TNCTRobocon/DROID/Reference/MDUdisaster_v4.1/MDU(droid)v4.1.brd

## EAGLE design Reference/MDUdisaster_v4.1/MDU(droid)v4.1.brd (2018-09-09)

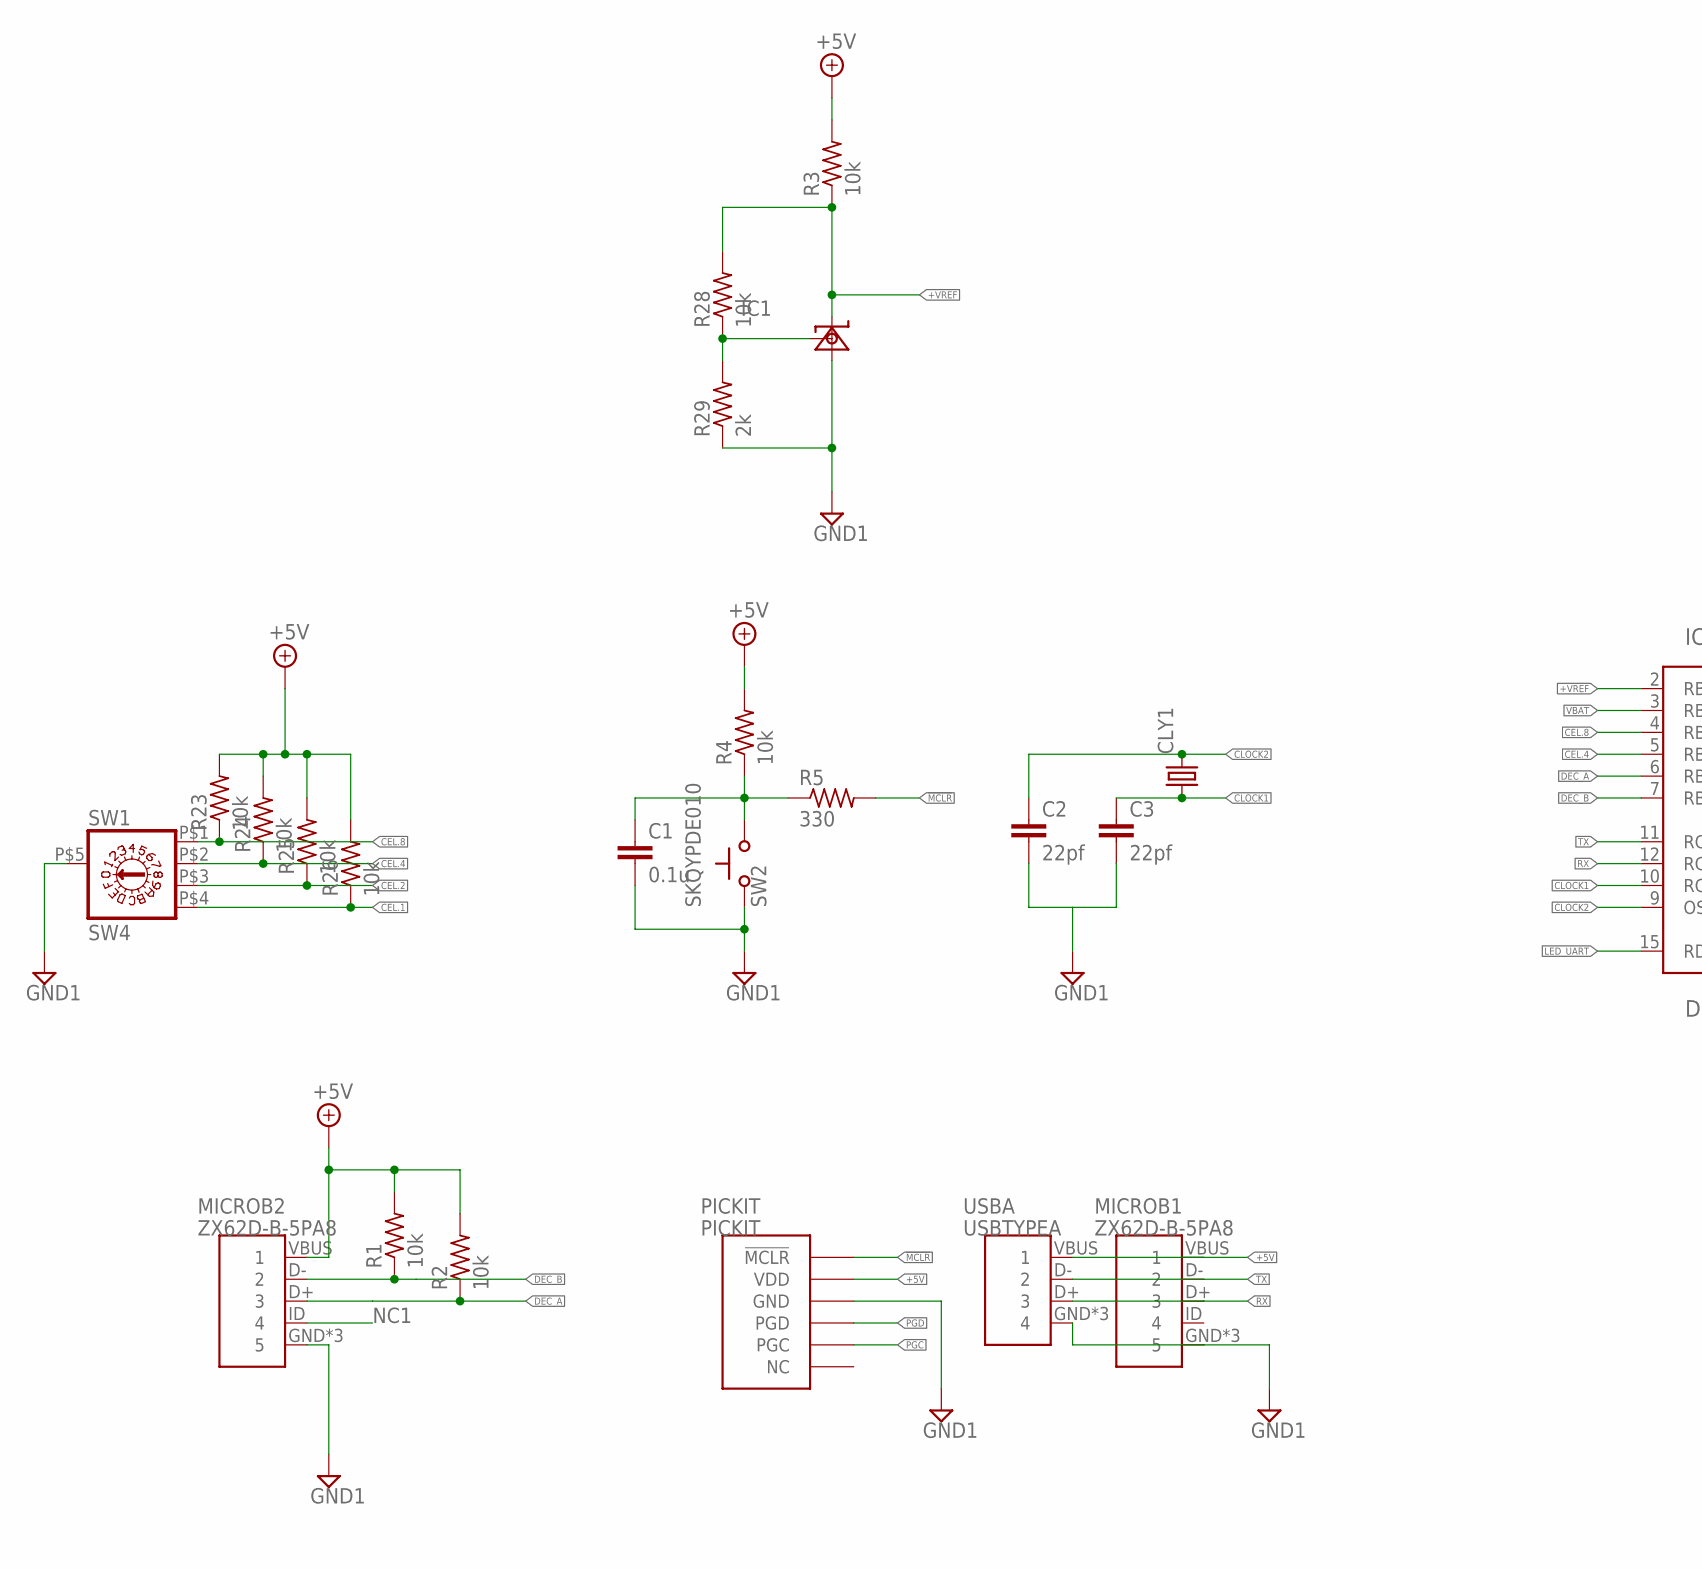
[picture p1: schematic MDU(droid)v4.1.sch, sheet 1, IC部, part in row 1, column 1]

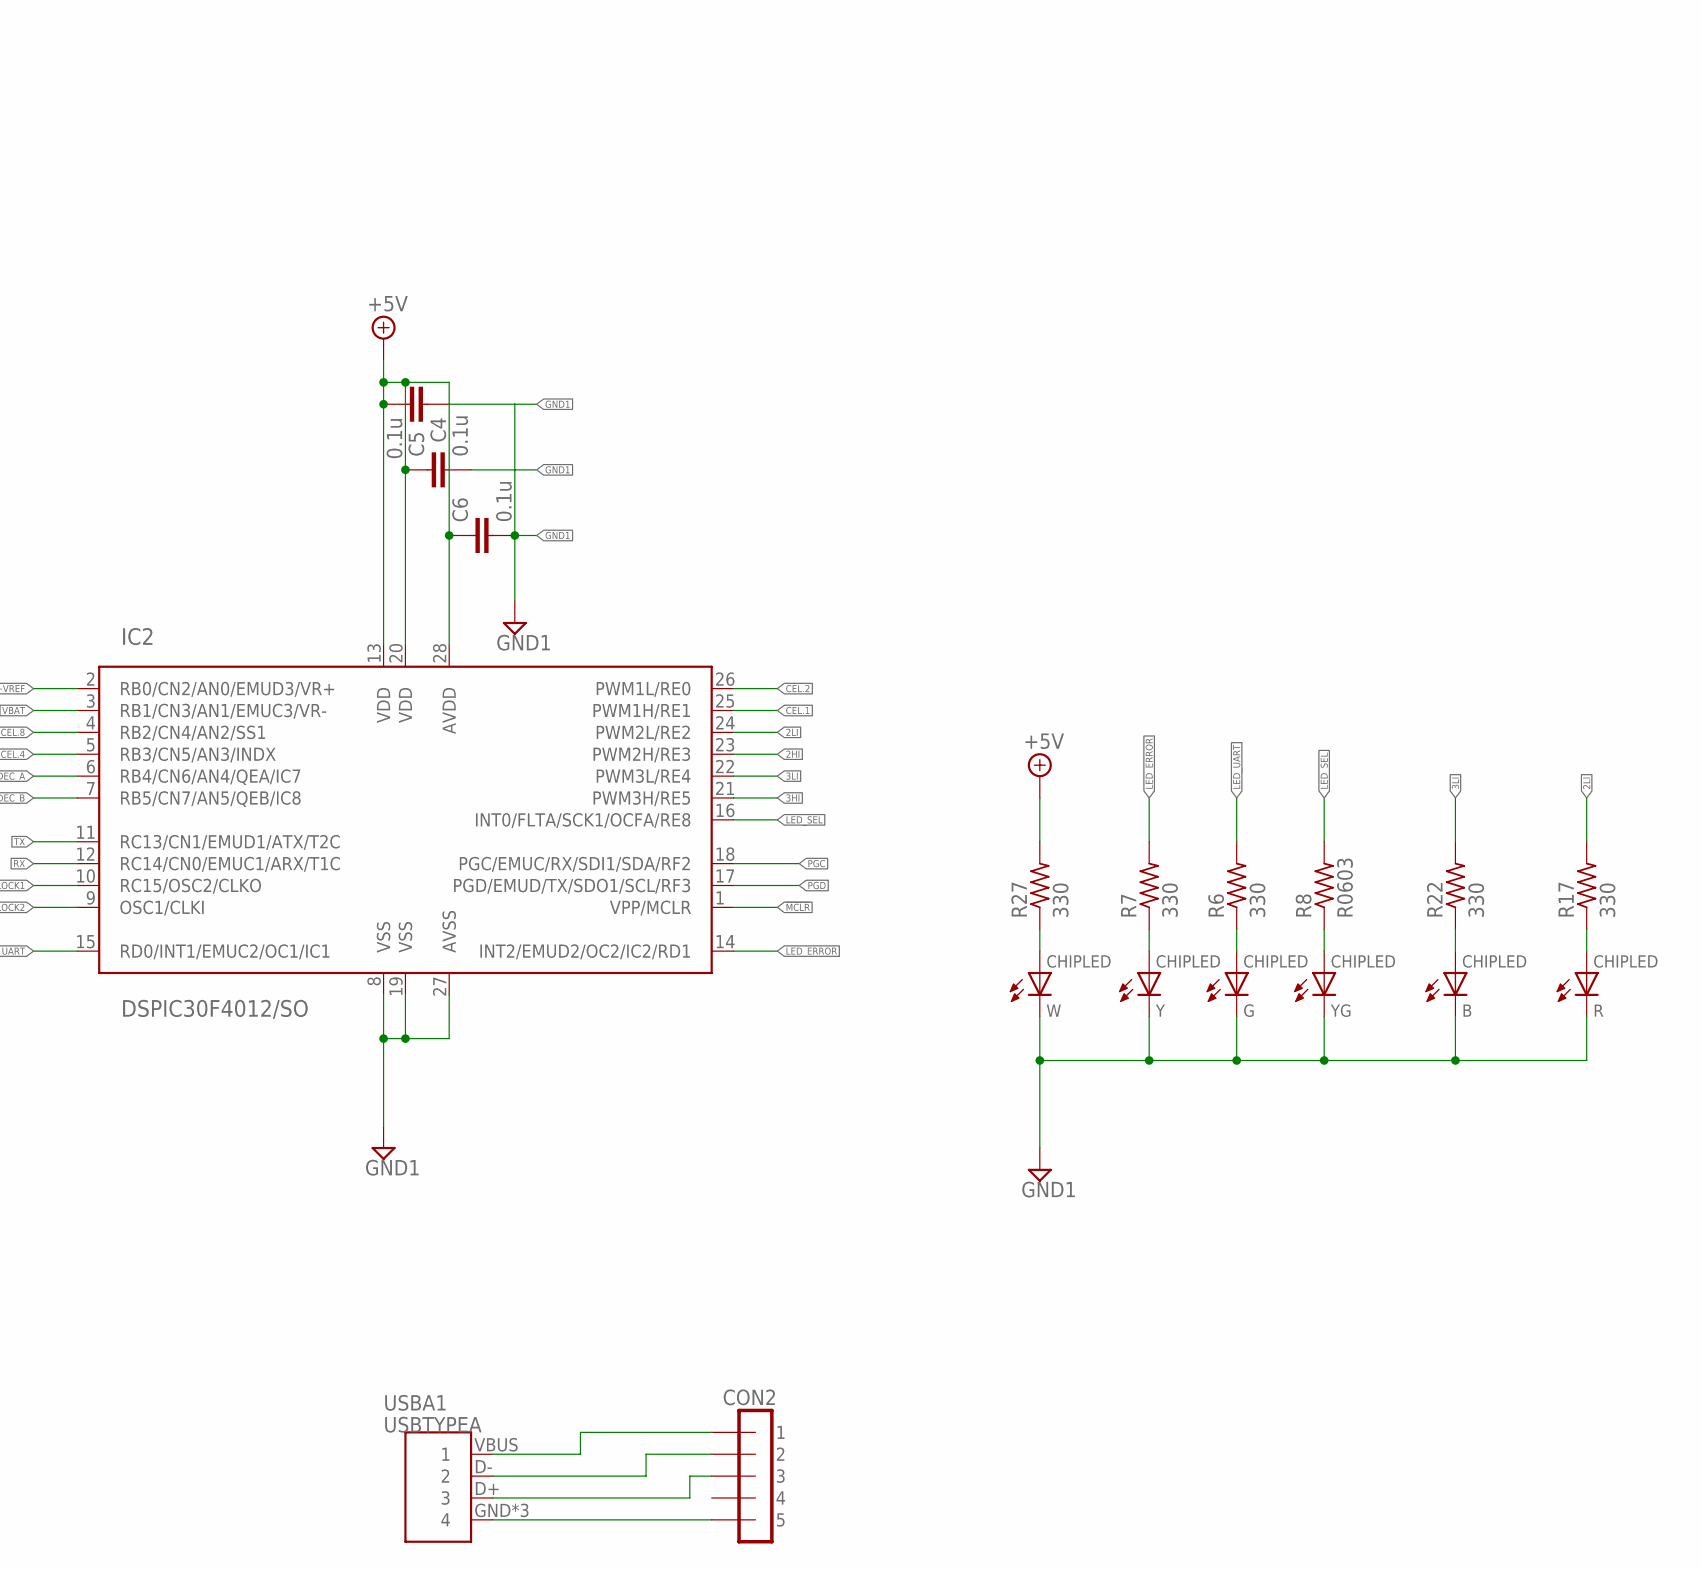
[picture p2: schematic MDU(droid)v4.1.sch, sheet 1, IC部, part in row 1, column 2]

Parts:
B: CHIPLED; CHIPLED_0603
C1, C4, C5, C6: 0.1u; C0603
C2, C3: 22pf; C0603
CLY1: CRYSTALHC49S; HC49/S
CON2: CON-5; 5-L
G: CHIPLED; CHIPLED_0603
IC1: TA76431F; SOT89
IC2: DSPIC30F4012/SO; SO-28W
MICROB1, MICROB2: ZX62D-B-5PA8; USB-B-MICRO-SMD
PICKIT: PICKIT; 1X06
R: CHIPLED; CHIPLED_0603
R1, R2, R3, R4, R23, R24, R25, R26, R28: 10k; R0603
R5, R6, R7, R17, R22, R27: 330; R0603
R8: R0603
R29: 2k; R0603
SW1: SW4; DRS3016
SW2: SKQYPDE010
USBA, USBA1: USBTYPEA; USB-A-H
W: CHIPLED; CHIPLED_0603
Y: CHIPLED; CHIPLED_0603
YG: CHIPLED; CHIPLED_0603

Connections:
2HI: IC2.23 (PWM2H/RE3); also elsewhere on the board
2LI: IC2.24 (PWM2L/RE2), R17.2; also elsewhere on the board
3HI: IC2.21 (PWM3H/RE5); also elsewhere on the board
3LI: IC2.22 (PWM3L/RE4), R22.2; also elsewhere on the board
!MCLR: IC2.1 (VPP/MCLR), PICKIT.1 (!MCLR), R5.2
+5V: C4.2, C5.1, C6.1, IC2.13 (VDD), IC2.20 (VDD), IC2.28 (AVDD), MICROB1.VBUS (1), MICROB2.VBUS (1), PICKIT.2 (VDD), R1.2, R2.2, R3.2, R4.2, R23.2, R24.2, R25.2, R26.2, R27.2, USBA.VBUS (1)
+VREF: IC1.1 (K), IC2.2 (RB0/CN2/AN0/EMUD3/VR+), R3.1, R28.2
CEL.1: IC2.25 (PWM1H/RE1), R26.1, SW1.P$4 (8)
CEL.2: IC2.26 (PWM1L/RE0), R25.1, SW1.P$3 (4)
CEL.4: IC2.5 (RB3/CN5/AN3/INDX), R24.1, SW1.P$2 (2)
CEL.8: IC2.4 (RB2/CN4/AN2/SS1), R23.1, SW1.P$1 (1)
CLOCK1: C3.1, CLY1.1, IC2.10 (RC15/OSC2/CLKO)
CLOCK2: C2.1, CLY1.2, IC2.9 (OSC1/CLKI)
DEC_A: IC2.6 (RB4/CN6/AN4/QEA/IC7), MICROB2.D+ (3), R2.1
DEC_B: IC2.7 (RB5/CN7/AN5/QEB/IC8), MICROB2.D- (2), R1.1
GND1: B.C, C1.2, C2.2, C3.2, C4.1, C5.2, C6.2, G.C, IC1.2 (A), IC1.2@1 (A), IC2.8 (VSS), IC2.19 (VSS), IC2.27 (AVSS), MICROB1.GND (5), MICROB1.SHIELD1 (5), MICROB1.SHIELD2 (5), MICROB2.GND (5), MICROB2.SHIELD1 (5), MICROB2.SHIELD2 (5), PICKIT.3 (GND), R.C, R29.1, SW1.P$5 (C), SW2.SW1, USBA.GND (4), USBA.SHLD1 (4), USBA.SHLD2 (4), W.C, Y.C, YG.C; also elsewhere on the board
LED_ERROR: IC2.14 (INT2/EMUD2/OC2/IC2/RD1), R7.2
LED_SEL: IC2.16 (INT0/FLTA/SCK1/OCFA/RE8), R8.2
LED_UART: IC2.15 (RD0/INT1/EMUC2/OC1/IC1), R6.2
MCLR: C1.1, R4.1, R5.1, SW2.SW2
unnamed: R27.1, W.A
unnamed: G.A, R6.1
unnamed: R8.1, YG.A
unnamed: IC1.3 (REF), R28.1, R29.2
unnamed: CON2.P$1 (1), USBA1.VBUS (1)
unnamed: CON2.P$5 (5), USBA1.GND (4), USBA1.SHLD1 (4), USBA1.SHLD2 (4)
unnamed: CON2.P$2 (2), USBA1.D- (2)
unnamed: R7.1, Y.A
unnamed: R.A, R17.1
unnamed: B.A, R22.1
unnamed: CON2.P$3 (3), USBA1.D+ (3)
NC1: MICROB2.ID (4)
PGC: IC2.18 (PGC/EMUC/RX/SDI1/SDA/RF2), PICKIT.5 (PGC)
PGD: IC2.17 (PGD/EMUD/TX/SDO1/SCL/RF3), PICKIT.4 (PGD)
RX: IC2.12 (RC14/CN0/EMUC1/ARX/T1C), MICROB1.D+ (3), USBA.D+ (3)
TX: IC2.11 (RC13/CN1/EMUD1/ATX/T2C), MICROB1.D- (2), USBA.D- (2)
VBAT: IC2.3 (RB1/CN3/AN1/EMUC3/VR-); also elsewhere on the board

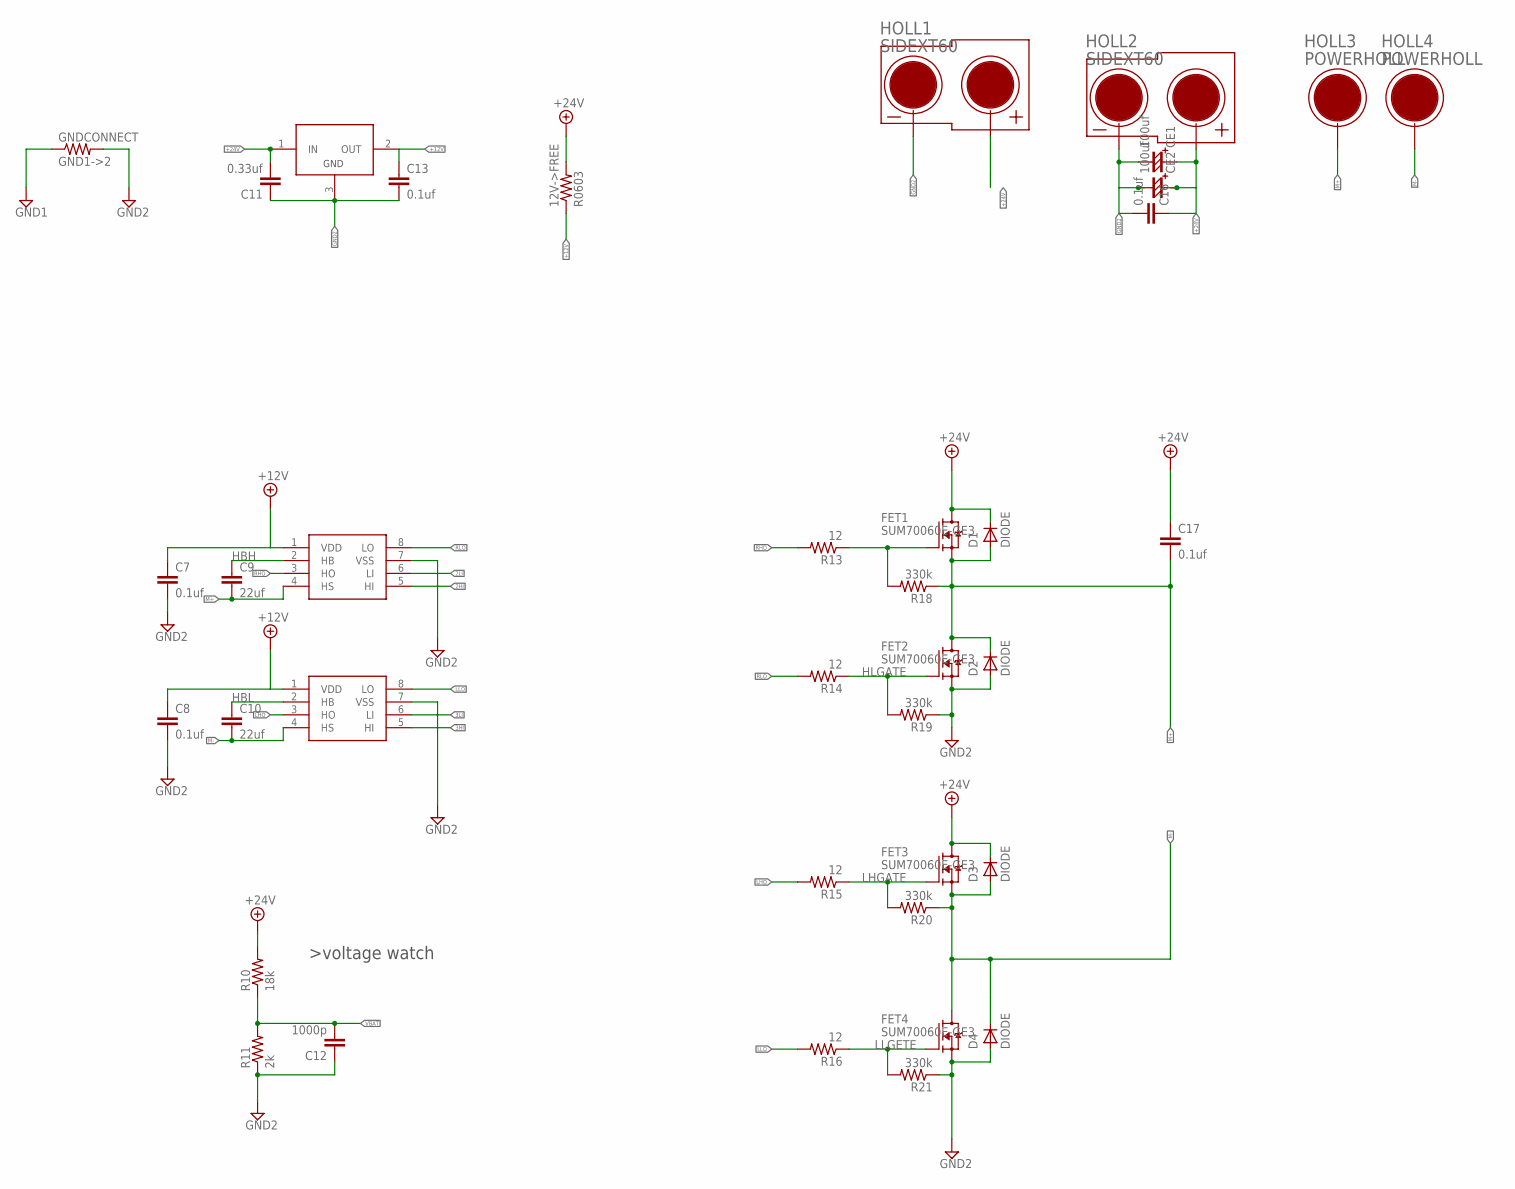
[picture p3: schematic MDU(droid)v4.1.sch, sheet 2, 駆動部]

Parts:
12V->FREE: R0603
C7, C8, C13, C16, C17: 0.1uf; C0603
C9, C10: 22uf; C0603
C11: 0.33uf; C0603
C12: 1000p; C0603
CE1, CE2: 100uf; CE1
D1, D2, D3, D4: DIODE; DO35-7A
FET1, FET2, FET3, FET4: SUM70060E-GE3; TO263AB
GNDCONNECT: GND1->2; R0603
HOLL1, HOLL2: SIDEXT60
HOLL3, HOLL4: POWERHOLL
IC3: MC7812BD2TG; TO263
IC5: MIC4604; SOIC8
MIC4604: MIC4604; SOIC8
R10: 18k; R0603
R11: 2k; R0603
R13, R14, R15, R16: 12; R0603
R18, R19, R20, R21: 330k; R0603

Connections:
2HI: MIC4604.5 (HI); also elsewhere on the board
2LI: MIC4604.6 (LI); also elsewhere on the board
3HI: IC5.5 (HI); also elsewhere on the board
3LI: IC5.6 (LI); also elsewhere on the board
+12V: 12V->FREE.1, C7.1, C8.1, C13.1, IC3.2 (OUT), IC5.1 (VDD), MIC4604.1 (VDD)
+24V: 12V->FREE.2, C11.2, C16.1, C17.1, CE1.1 (A), CE2.1 (A), D1.C, D3.C, FET1.K (D), FET3.K (D), HOLL1.P$2, HOLL1.P$4, HOLL2.P$2, HOLL2.P$4, IC3.1 (IN), R10.2
FETHHGATE: FET1.1 (G), R13.1, R18.2
GND1: GNDCONNECT.1; also elsewhere on the board
GND2: C7.2, C8.2, C11.1, C12.1, C13.2, C16.2, CE1.2 (C), CE2.2 (C), D2.A, D4.A, FET2.2 (S), FET4.2 (S), GNDCONNECT.2, HOLL1.P$1, HOLL1.P$3, HOLL2.P$1, HOLL2.P$3, IC3.3 (GND), IC5.7 (VSS), MIC4604.7 (VSS), R11.1, R19.1, R21.1
HBH: C9.1, MIC4604.2 (HB)
HBL: C10.1, IC5.2 (HB)
HLGATE: FET2.1 (G), R14.1, R19.2
LHGATE: FET3.1 (G), R15.1, R20.2
LHO: IC5.3 (HO), R15.2
LLGETE: FET4.1 (G), R16.1, R21.2
LLO: IC5.8 (LO), R16.2
M+: C9.2, C17.2, D1.A, D2.C, FET1.2 (S), FET2.K (D), HOLL3.P$1, MIC4604.4 (HS), R18.1
M-: C10.2, D3.A, D4.C, FET3.2 (S), FET4.K (D), HOLL4.P$1, IC5.4 (HS), R20.1
RHO: MIC4604.3 (HO), R13.2
RLO: MIC4604.8 (LO), R14.2
VBAT: C12.2, R10.1, R11.2; also elsewhere on the board

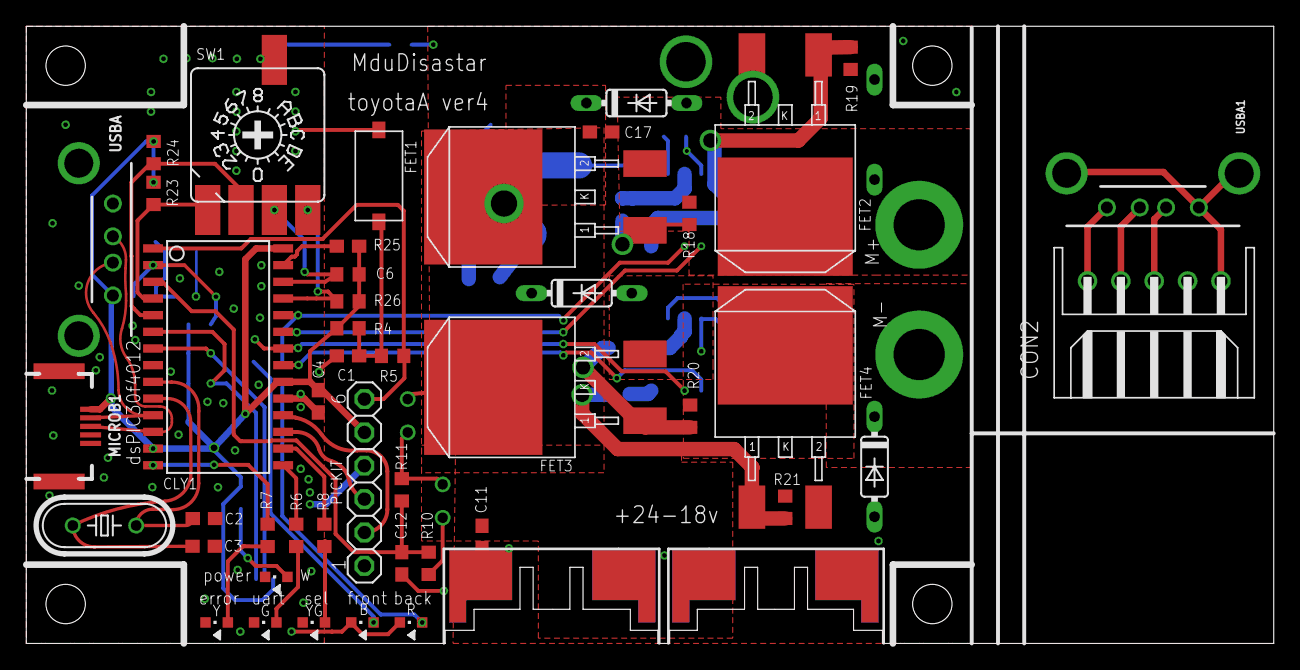
[picture p4: board MDU(droid)v4.1.brd from above]

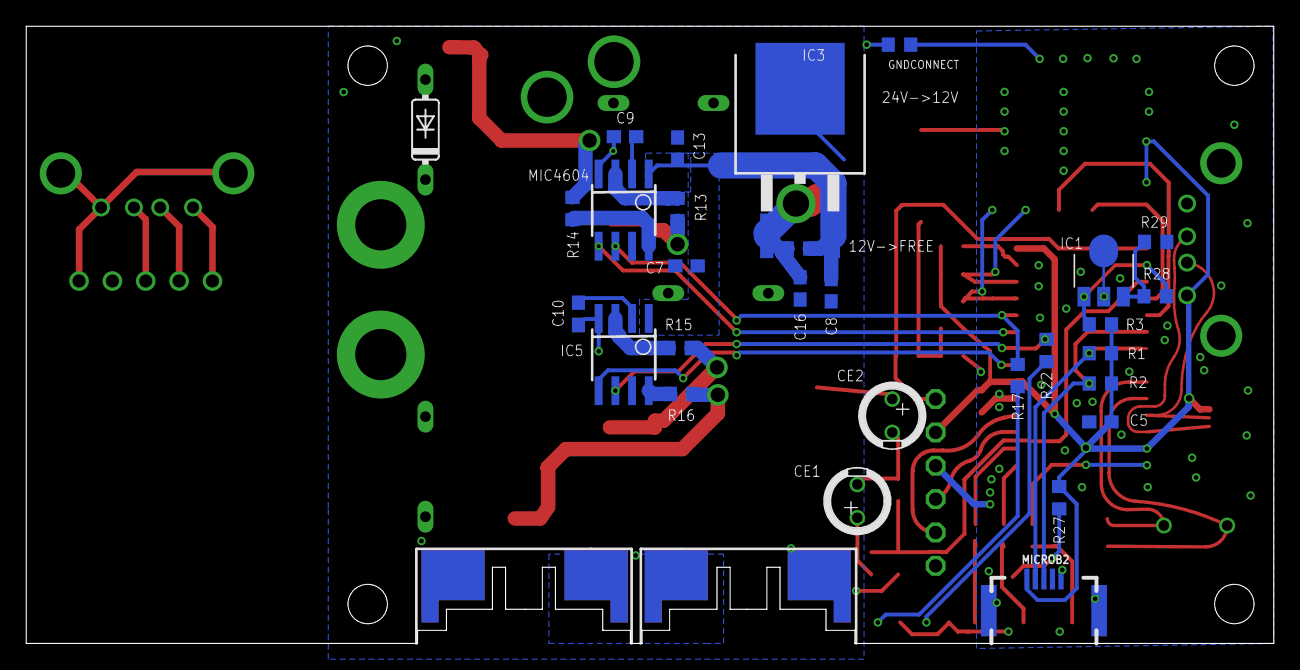
[picture p5: board MDU(droid)v4.1.brd from below]

Board: 2 copper layers, 95.0 x 47.0 mm, 78 parts (30 on the bottom side), 51 nets.
