TNCTRobocon/DROID/Setting/configuration.h

/* 
 * File:   configuration.h
 * Author: TERU
 *
 * Created on 2016/03/23, 0:16
 */

#ifndef CONFIGURATION_H
#define	CONFIGURATION_H


//デバイス環境
#include "p30F4012.h"


//環境構築
#define FORIG (1000000UL)
#define FOSC (FORIG*8/4) //10[MHz]*8[PLL]/4[DIV]=20[MHz] 

//10MHz*8(PLL)/4(divsion))

//デバイスを選択する
#define DEVICE_COMMON
//#define DEVICE_DRAGON
#define ADC_USE
#if defined(DEVICE_COMMON)
#define PORT_TYPE_A
#elif defined(DEVICE_DRAGON)
#define PORT_TYPE_B

#endif


//アドレス取得　ピン配置
#if defined(PORT_TYPE_A)
#define PIN_SEL1() PORTBbits.RB2
#define PIN_SEL2() PORTEbits.RE8
#define PIN_SEL4() PORTEbits.RE0
#define PIN_SEL8() PORTEbits.RE1
#define TRIS_SEL1(X) TRISBbits.TRISB2=(X)
#define TRIS_SEL2(X) TRISEbits.TRISE8=(X)
#define TRIS_SEL4(X) TRISEbits.TRISE0=(X)
#define TRIS_SEL8(X) TRISEbits.TRISE1=(X)
#elif defined(PORT_TYPE_B)

//TODO ピン配置を設定する
#endif
//Stoper
#define SW_ST()   PORTEbits.RE8

//LED
#define LED_RX      LATDbits.LATD0
#define LED_TX      LATDbits.LATD1
#define LED_ERROR   LATDbits.LATD1
#define LED_APP     LATBbits.LATB2

#define PIN_HIGH(x) ((x)=true)
#define PIN_LOW(x)  ((x)=false)
#define PIN_INV(x)  ((x)=(^x))

//PWM
#define ST_PIN      LATEbits.LATE4
//UART
#define RX_BUFFER_SIZE  (64) //受信バッファの一つ当たりの大きさ
#define TX_BUFFER_SIZE  (64)
#define CMD_LENGTH (32)        // システムが受け入れられる文字の最大数、
#define CMD_MAX     (16)        // 最大分割数(1LINEあたり)
#define FILE_MAX    (32)        // 最大ファイル数
#define MULTI_MAX (8) //同時に実行できるコマンドの最大値
#define WORD_MAX (32)
#define PATH_DEPTH_MAX (8)
#define QUICK_MAX (8) 
#define WORD_MAX (32)
#define SYSTEM_SIZE (32)        //  システムに登録できる機能数

//EEPROM
#define EEPROM_BUFFER_SIZE (64) //EEPROMの書き込み用バッファ

//ADC





#endif	/* CONFIGURATION_H */
