TNCTRobocon/DROID/Setting/configuration.c

// DSPIC30F4012 Configuration Bit Settings

// 'C' source line config statements

#include "configuration.h"


// DSPIC30F4012 Configuration Bit Settings

// 'C' source line config statements



// FOSC
#pragma config FPR = XT_PLL8           // Primary Oscillator Mode (XT w/PLL 8x)
#pragma config FOS = PRI                // Oscillator Source (Primary Oscillator)
#pragma config FCKSMEN = CSW_FSCM_OFF   // Clock Switching and Monitor (Sw Disabled, Mon Disabled)

// FWDT
#pragma config FWPSB = WDTPSB_16        // WDT Prescaler B (1:16)
#pragma config FWPSA = WDTPSA_512       // WDT Prescaler A (1:512)
#pragma config WDT = WDT_OFF            // Watchdog Timer (Disabled)

// FBORPOR
#pragma config FPWRT = PWRT_64          // POR Timer Value (64ms)
#pragma config BODENV = BORV42          // Brown Out Voltage (4.2V)
#pragma config BOREN = PBOR_ON          // PBOR Enable (Enabled)
#pragma config LPOL = PWMxL_ACT_LO      // Low-side PWM Output Polarity (Active High)
#pragma config HPOL = PWMxH_ACT_HI      // High-side PWM Output Polarity (Active High)
#pragma config PWMPIN = RST_IOPIN       // PWM Output Pin Reset (Control with PORT/TRIS regs)
#pragma config MCLRE = MCLR_EN          // Master Clear Enable (Enabled)

// FGS
#pragma config GWRP = GWRP_OFF          // General Code Segment Write Protect (Disabled)
#pragma config GCP = CODE_PROT_OFF      // General Segment Code Protection (Disabled)

// FICD
#pragma config ICS = ICS_PGD            // Comm Channel Select (Use PGC/EMUC and PGD/EMUD)

/*
// FOSC
#pragma config FPR = FRC_PLL8           // Primary Oscillator Mode (FRC w/ PLL 8x)
#pragma config FOS = FRC                // Oscillator Source (Internal Fast RC)
#pragma config FCKSMEN = CSW_FSCM_OFF   // Clock Switching and Monitor (Sw Disabled, Mon Disabled)

// FWDT
#pragma config FWPSB = WDTPSB_16        // WDT Prescaler B (1:16)
#pragma config FWPSA = WDTPSA_512       // WDT Prescaler A (1:512)
#pragma config WDT = WDT_OFF            // Watchdog Timer (Disabled)

// FBORPOR
#pragma config FPWRT = PWRT_64          // POR Timer Value (64ms)
#pragma config BODENV = BORV42          // Brown Out Voltage (4.2V)
#pragma config BOREN = PBOR_ON          // PBOR Enable (Enabled)
#pragma config LPOL = PWMxL_ACT_HI      // Low-side PWM Output Polarity (Active High)
#pragma config HPOL = PWMxH_ACT_HI      // High-side PWM Output Polarity (Active High)
#pragma config PWMPIN = RST_IOPIN       // PWM Output Pin Reset (Control with PORT/TRIS regs)
#pragma config MCLRE = MCLR_EN          // Master Clear Enable (Enabled)

// FGS
#pragma config GWRP = GWRP_OFF          // General Code Segment Write Protect (Disabled)
#pragma config GCP = CODE_PROT_OFF      // General Segment Code Protection (Disabled)

// FICD
#pragma config ICS = ICS_PGD            // Comm Channel Select (Use PGC/EMUC and PGD/EMUD)
*/
