TNCTRobocon/DROID/Driver/ports.c

#include "../Setting/configuration.h"
#include "ports.h"

void ports_setup(){
    //Switch (STOP)
    //TRISEbits.TRISE8=true;
    //Switch Address (Din)
    TRIS_SEL1(true);
    TRIS_SEL2(true);
    TRIS_SEL4(true);
    TRIS_SEL8(true);
    
    ADPCFGbits.PCFG0=true;
    ADPCFGbits.PCFG1=true;
    //ENCODER (Din)
    TRISBbits.TRISB4=true;
    TRISBbits.TRISB5=true;
    
    
    ADPCFGbits.PCFG4=true;
    ADPCFGbits.PCFG5=true;

    //LED(Dout)
    TRISDbits.TRISD1=false;//LED_ERROR
    TRISDbits.TRISD0=false;//LED_APP
    
    LATDbits.LATD0=false;
    LATDbits.LATD1=false;
    //UART
    TRISCbits.TRISC14=true;//RX
    TRISCbits.TRISC13=false;//TX

    //PWM
    //TRISEbits.TRISE0=false;//HalfBridge L LOW
    //TRISEbits.TRISE1=false;//HalfBridge L HIGH
    TRISEbits.TRISE2=false;//HalfBridge R LOW
    TRISEbits.TRISE3=false;//HalfBridge R HIGH
    TRISEbits.TRISE4=false;//HalfBridge L LOW
    TRISEbits.TRISE5=false;//HalfBridge L HIGH
    //PWM_ENABLE
    //PORTEbits.RE0=false;//HalfBridge L LOW
    //PORTEbits.RE1=false;//HalfBridge L HIGH
    PORTEbits.RE2=false;//HalfBridge R LOW
    PORTEbits.RE3=false;//HalfBridge R HIGH
    PORTEbits.RE4=false;//HalfBridge L LOW
    PORTEbits.RE5=false;//HalfBridge L HIGH
}

inline uint16_t port_address(){
    return  ((!PIN_SEL1())<<1)+
            ((!PIN_SEL2())<<0)+
            ((!PIN_SEL4())<<3)+
            ((!PIN_SEL8())<<2);   
}

inline void led_rx(bool fag){
    LED_RX=fag;
}

inline int16_t port_get(int idx){
    switch (idx){
        case 1:
            return PORTB;
        case 2:
            return PORTC;
        case 3:
            return PORTD;
        case 4:
            return PORTE;
        case 5:
            return PORTF;
        default:
            return -1;//ERROR
    }
}

inline bool pin_encode_idx(){
    return PORTBbits.RB3;
}
inline bool pin_encode_x(){
    return PORTBbits.RB4;
}
inline bool pin_encode_y(){
    return PORTBbits.RB5;
}
