TNCTRobocon/DROID/(commit log)

2018-06-21 PUSHしてみました
    [configuration.h]
2018-07-08 Revert "PWMは設定済み ADCの設定を追加 サンプリング周期を決めたい"
    This reverts commit 5923e85938e03e0fd10f93974be49abbf8182944.
2018-07-10 ADの設定を追加
2018-07-12 pid処理を追加 動作確認はしていない
2018-07-16 motor.cとmotor.hをappに移動 EShellを移植
    [configuration.h]
2018-08-23 バッテリ監視用コマンドbtypeを追加
2018-08-23 motor.cとmotor.hを追加（なぜか追加されていなかった）
2018-08-24 gitignoreを追加
2018-08-24 佐藤君のモタドラからコマンドを移植
    [configuration.h]
2018-08-24 バッテリーチェック用のコマンド check 追加
2018-08-25 関数の名前を変更
2018-08-25 gitignore のtest
2018-08-25 nbproject を切った
2018-08-25 余計なファイルを切れたはず
2018-08-26 余計なファイルの追跡を削除
2018-08-27 sel の設定を追加 dtコマンドがはじかれるようになった
    [configuration.h]
2018-08-27 モーターの正転動作を確認
2018-08-28 佐藤君のプログラムからコマンドを移植
    [configuration.h]
2018-08-29 コマンドがはじかれないことを確認
2018-08-31 バグの修正
2018-09-04 Add files via upload
    ファイル構成を変更
2018-09-04 バグを修正
2018-09-06 モーターの正転、逆転の動作を確認
2018-09-09 データシート、回路図を追加
    [MDU(droid)v4.1.brd, MDU(droid)v4.1.sch]
